RunningPenguin/ESP32_GRBL_SUBD/ESP32_GRBL_SUBD/ESP32_GRBL_SUBD.kicad_pcb

## KiCad design ESP32_GRBL_SUBD/ESP32_GRBL_SUBD.kicad_pcb (2022-12-30)

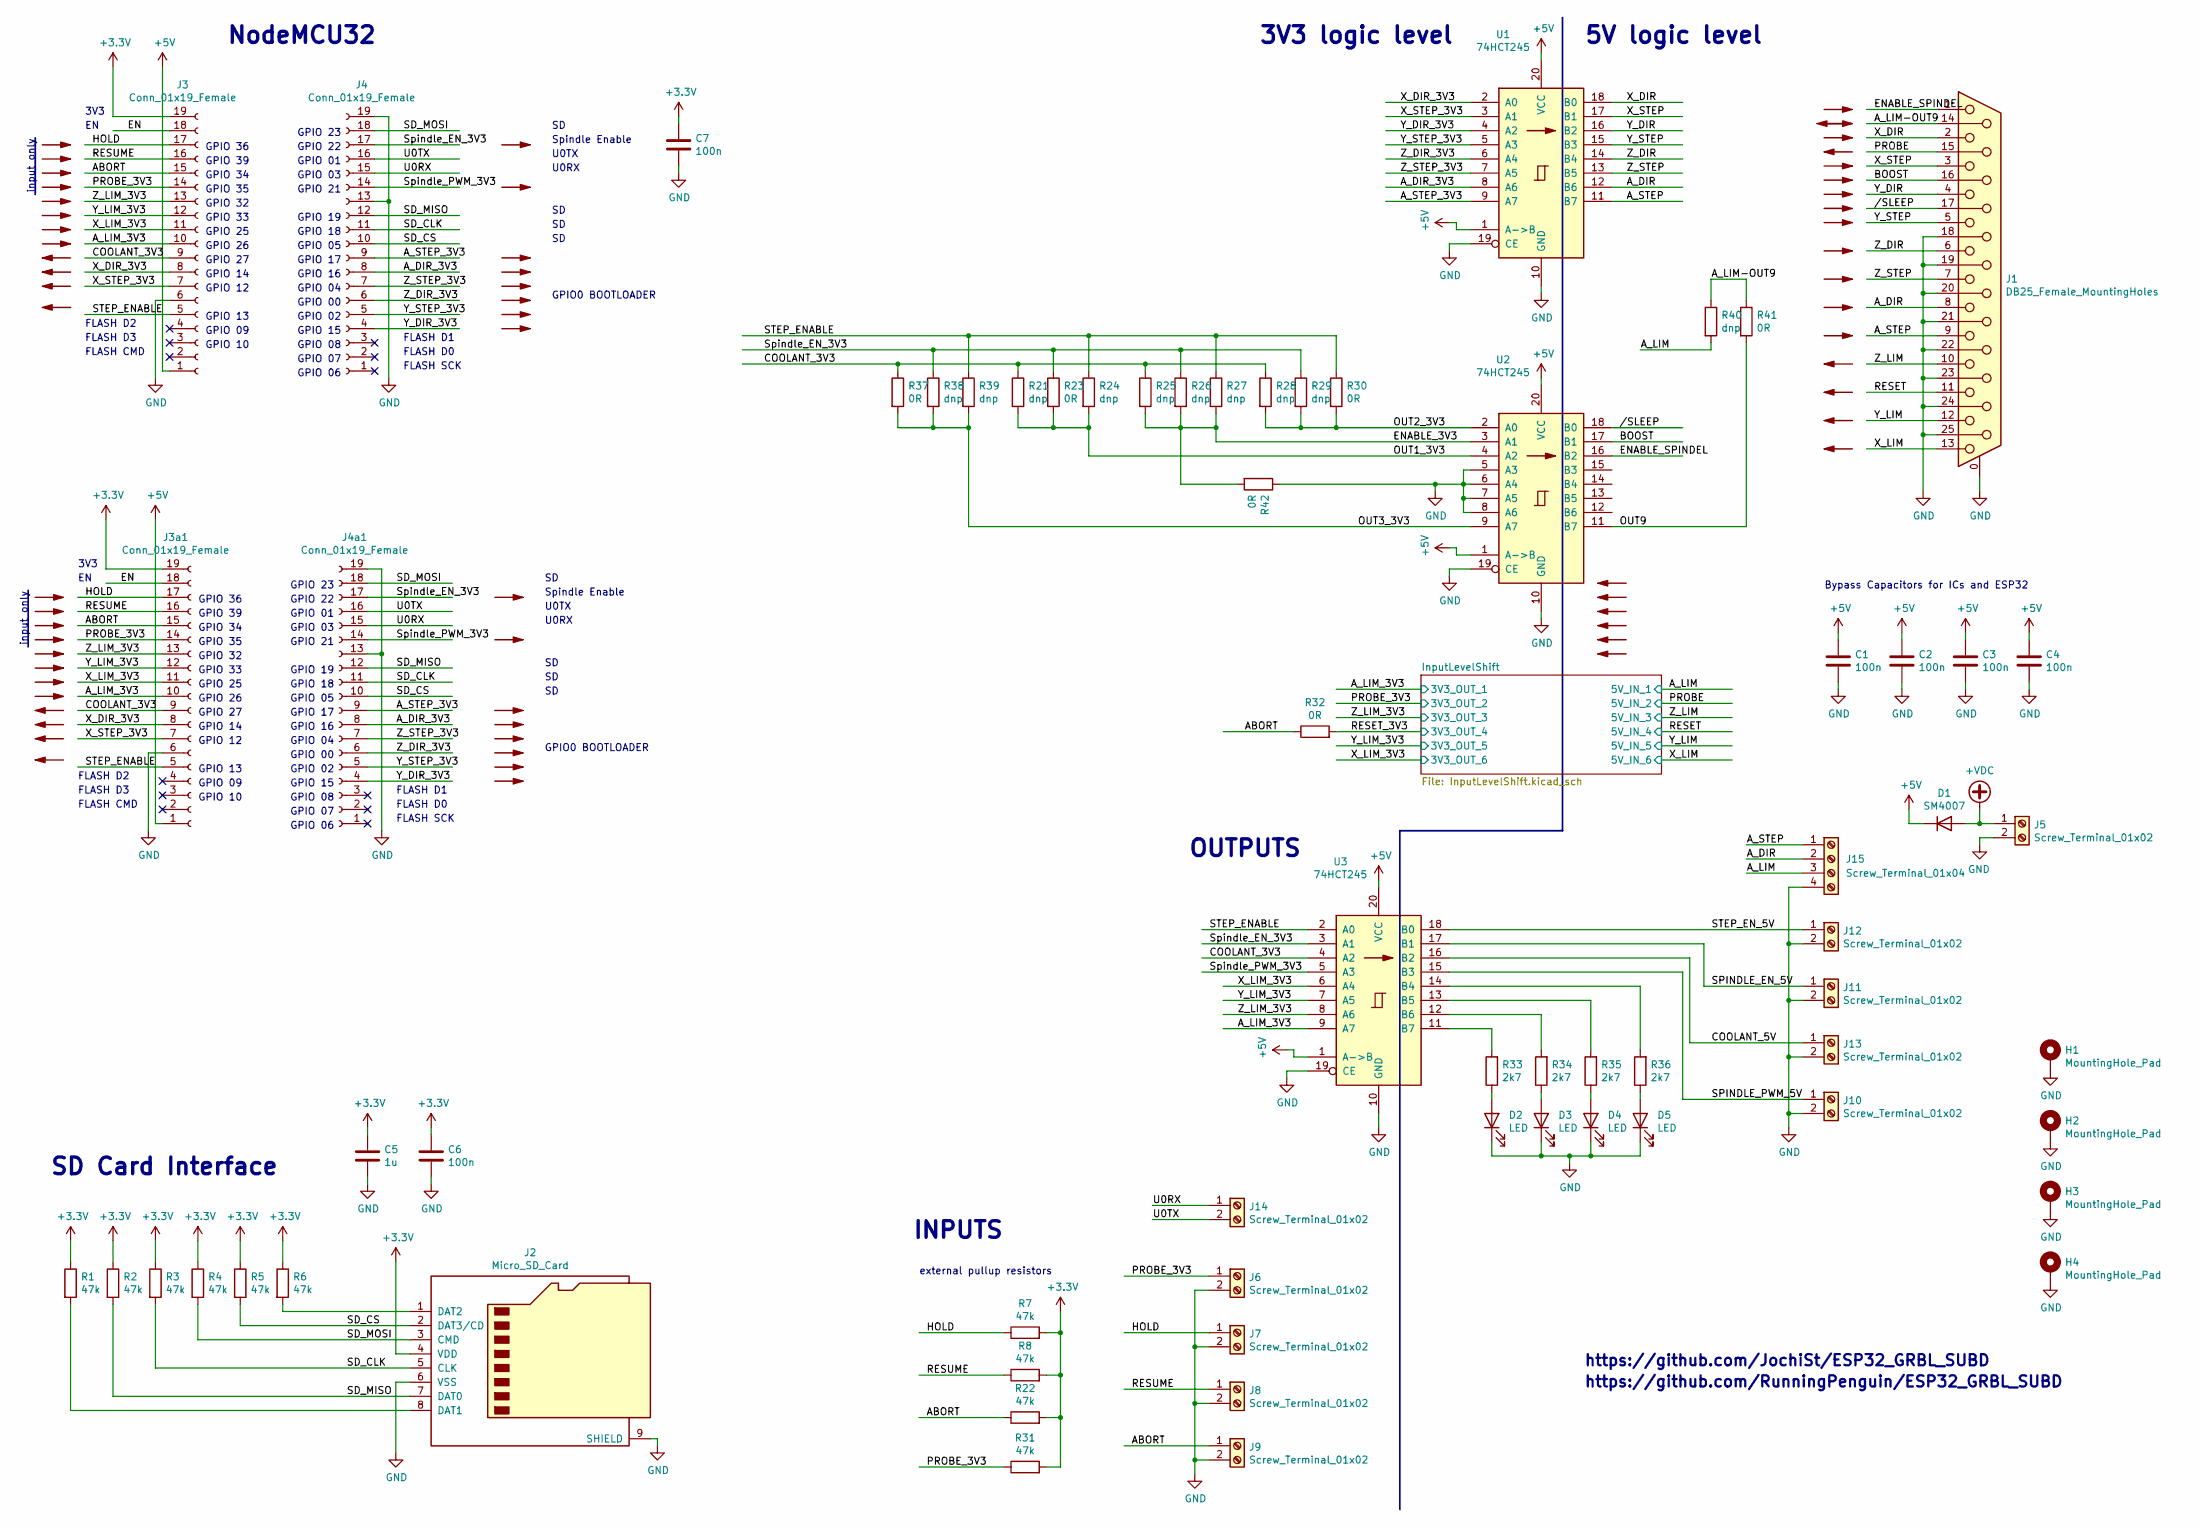
[picture p1: schematic ESP32_GRBL_SUBD.kicad_sch, ESP32 GRBL SUB-D25]

Parts:
C1, C2, C3, C4, C6, C7: 100n; C_0603_1608Metric
C5: 1u; C_0603_1608Metric
D1: SM4007; D_MELF
D2, D3, D4, D5: LED; LED_0603_1608Metric
H1, H2, H3, H4: MountingHole_Pad; MountingHole_3.2mm_M3_Pad_Via
J1: DB25_Female_MountingHoles; DSUB-25_Female_Horizontal_P2.77x2.84mm_EdgePinOffset7.70mm_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
J2: Micro_SD_Card; microSD_HC_Wuerth_693072010801
J3, J3a1, J4, J4a1: Conn_01x19_Female; PinSocket_1x19_P2.54mm_Vertical
J5, J6, J7, J8, J9, J10, J11, J12, J13, J14: Screw_Terminal_01x02; TerminalBlock_MetzConnect_Type055_RT01502HDWU_1x02_P5.00mm_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
J15: Screw_Terminal_01x04; TerminalBlock_MetzConnect_Type055_RT01504HDWU_1x04_P5.00mm_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
R1, R2, R3, R4, R5, R6, R7, R8, R22, R31: 47k; R_0603_1608Metric
R21, R24, R25, R26, R27, R28, R29, R38, R39, R40: dnp; R_0603_1608Metric
R23, R30, R32, R37, R41, R42: 0R; R_0603_1608Metric
R33, R34, R35, R36: 2k7; R_0603_1608Metric
U1, U2, U3: 74HCT245; SO-20_12.8x7.5mm_P1.27mm

Connections:
+3V3: C5.1, C6.1, C7.1, J2.4 (VDD), J3.19, J3a1.19, R1.1, R2.1, R3.1, R4.1, R5.1, R6.1, R7.2, R8.2, R22.2, R31.2; also elsewhere on the board
+5V: C1.1, C2.1, C3.1, C4.1, D1.1 (K), J3.1, J3a1.1, U1.1 (A->B), U1.20 (VCC), U2.1 (A->B), U2.20 (VCC), U3.1 (A->B), U3.20 (VCC); also elsewhere on the board
+VDC: D1.2 (A), J5.1
/ABORT: J3.15, J3a1.15, J9.1, R22.1, R32.1
/A_DIR: J1.8, J15.2, U1.12 (B6)
/A_DIR_3V3: J4.8, J4a1.8, U1.8 (A6)
/A_LIM: J15.3, R40.2; also elsewhere on the board
/A_LIM-OUT9: J1.14, R40.1, R41.1
/A_LIM_3V3: J3.10, J3a1.10, U3.9 (A7); also elsewhere on the board
/A_STEP: J1.9, J15.1, U1.11 (B7)
/A_STEP_3V3: J4.9, J4a1.9, U1.9 (A7)
/BOOST: J1.16, U2.17 (B1)
/COOLANT_3V3: J3.9, J3a1.9, R21.1, R25.1, R28.1, R37.1, U3.4 (A2)
/COOLANT_5V: J13.1, U3.16 (B2)
/EN: J3.18, J3a1.18
/ENABLE_3V3: R25.2, R26.2, R27.2, R42.2, U2.3 (A1)
/ENABLE_SPINDEL: J1.1, U2.16 (B2)
/HOLD: J3.17, J3a1.17, J7.1, R7.1
/OUT1_3V3: R21.2, R23.2, R24.2, U2.4 (A2)
/OUT2_3V3: R28.2, R29.2, R30.2, U2.2 (A0)
/OUT3_3V3: R37.2, R38.2, R39.2, U2.9 (A7)
/OUT9: R41.2, U2.11 (B7)
/PROBE: J1.15; also elsewhere on the board
/PROBE_3V3: J3.14, J3a1.14, J6.1, R31.1; also elsewhere on the board
/RESET: J1.11; also elsewhere on the board
/RESET_3V3: R32.2; also elsewhere on the board
/RESUME: J3.16, J3a1.16, J8.1, R8.1
/SD_CLK: J2.5 (CLK), J4.11, J4a1.11, R3.2
/SD_CS: J2.2 (DAT3/CD), J4.10, J4a1.10, R5.2
/SD_MISO: J2.7 (DAT0), J4.12, J4a1.12, R2.2
/SD_MOSI: J2.3 (CMD), J4.18, J4a1.18, R4.2
/SPINDLE_EN_5V: J11.1, U3.17 (B1)
/SPINDLE_PWM_5V: J10.1, U3.15 (B3)
/STEP_ENABLE: J3.5, J3a1.5, R24.1, R27.1, R30.1, R39.1, U3.2 (A0)
/STEP_EN_5V: J12.1, U3.18 (B0)
/Spindle_EN_3V3: J4.17, J4a1.17, R23.1, R26.1, R29.1, R38.1, U3.3 (A1)
/Spindle_PWM_3V3: J4.14, J4a1.14, U3.5 (A3)
/U0RX: J4.15, J4a1.15, J14.1
/U0TX: J4.16, J4a1.16, J14.2
/X_DIR: J1.2, U1.18 (B0)
/X_DIR_3V3: J3.8, J3a1.8, U1.2 (A0)
/X_LIM: J1.13; also elsewhere on the board
/X_LIM_3V3: J3.11, J3a1.11, U3.6 (A4); also elsewhere on the board
/X_STEP: J1.3, U1.17 (B1)
/X_STEP_3V3: J3.7, J3a1.7, U1.3 (A1)
/Y_DIR: J1.4, U1.16 (B2)
/Y_DIR_3V3: J4.4, J4a1.4, U1.4 (A2)
/Y_LIM: J1.12; also elsewhere on the board
/Y_LIM_3V3: J3.12, J3a1.12, U3.7 (A5); also elsewhere on the board
/Y_STEP: J1.5, U1.15 (B3)
/Y_STEP_3V3: J4.5, J4a1.5, U1.5 (A3)
/Z_DIR: J1.6, U1.14 (B4)
/Z_DIR_3V3: J4.6, J4a1.6, U1.6 (A4)
/Z_LIM: J1.10; also elsewhere on the board
/Z_LIM_3V3: J3.13, J3a1.13, U3.8 (A6); also elsewhere on the board
/Z_STEP: J1.7, U1.13 (B5)
/Z_STEP_3V3: J4.7, J4a1.7, U1.7 (A5)
//SLEEP: J1.17, U2.18 (B0)
GND: C1.2, C2.2, C3.2, C4.2, C5.2, C6.2, C7.2, D2.1 (K), D3.1 (K), D4.1 (K), D5.1 (K), H1.1, H2.1, H3.1, H4.1, J1.0 (PAD), J1.18, J1.19, J1.20, J1.21, J1.22, J1.23, J1.24, J1.25, J2.6 (VSS), J2.9 (SHIELD), J3.6, J3a1.6, J4.13, J4.19, J4a1.13, J4a1.19, J5.2, J6.2, J7.2, J8.2, J9.2, J10.2, J11.2, J12.2, J13.2, J15.4, R42.1, U1.10 (GND), U1.19 (CE), U2.5 (A3), U2.6 (A4), U2.7 (A5), U2.8 (A6), U2.10 (GND), U2.19 (CE), U3.10 (GND), U3.19 (CE)
unnamed: D2.2 (A), R33.1
unnamed: D3.2 (A), R34.1
unnamed: D4.2 (A), R35.1
unnamed: D5.2 (A), R36.1
unnamed: J2.1 (DAT2), R6.2
unnamed: J2.8 (DAT1), R1.2
unnamed: R33.2, U3.11 (B7)
unnamed: R34.2, U3.12 (B6)
unnamed: R35.2, U3.13 (B5)
unnamed: R36.2, U3.14 (B4)

Notes on the sheet:
GPIO 03
GPIO 19
GPIO 21
GPIO 01
GPIO 09
FLASH D0
GPIO 15
GPIO 27
GPIO 33
GPIO0 BOOTLOADER
GPIO 08
U0RX
FLASH CMD
GPIO 12
GPIO 32
GPIO 04
GPIO 02
3V3
GPIO 35
OUTPUTS
Spindle Enable
https://github.com/JochiSt/ESP32_GRBL_SUBD
GPIO 00
GPIO 23
GPIO 22
GPIO 25
Bypass Capacitors for ICs and ESP32
FLASH SCK
GPIO 34
GPIO 07
GPIO 10
5V logic level
input only
GPIO 36
FLASH D2
SD Card Interface
GPIO 26
GPIO 06
U0TX
GPIO 16
external pullup resistors
GPIO 05
GPIO 14
GPIO 17
FLASH D3
GPIO 18
NodeMCU32
GPIO 13
3V3 logic level
https://github.com/RunningPenguin/ESP32_GRBL_SUBD
FLASH D1
GPIO 39
INPUTS

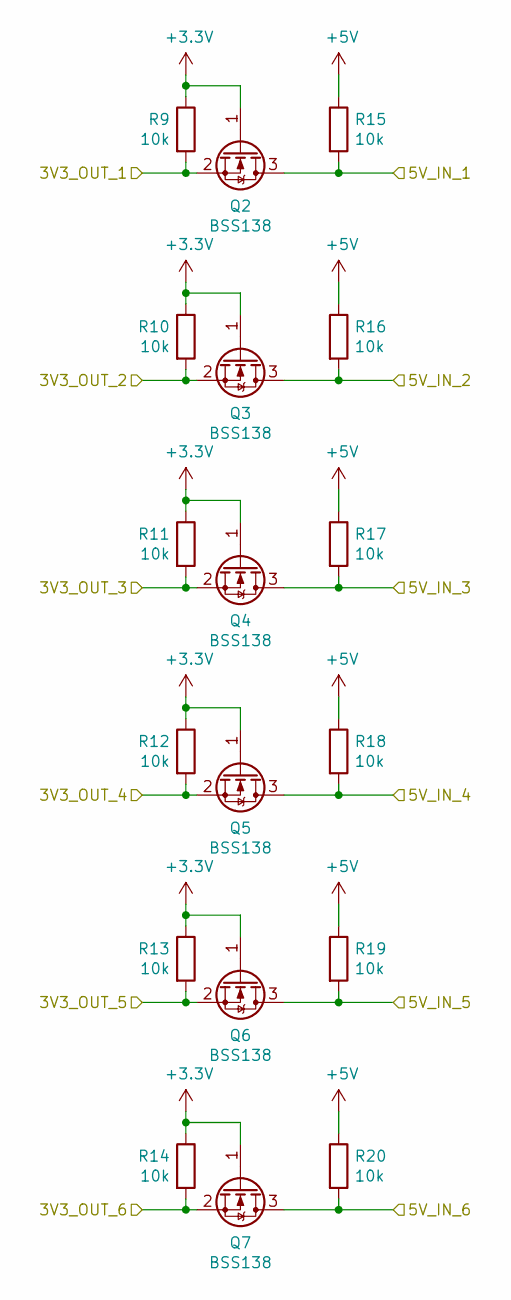
[picture p2: schematic InputLevelShift.kicad_sch, ESP32 GRBL SUB-D25]

Parts:
Q2, Q3, Q4, Q5, Q6, Q7: BSS138; SOT-23
R9, R10, R11, R12, R13, R14, R15, R16, R17, R18, R19, R20: 10k; R_0603_1608Metric

Connections:
+3V3: Q2.1 (G), Q3.1 (G), Q4.1 (G), Q5.1 (G), Q6.1 (G), Q7.1 (G), R9.1, R10.1, R11.1, R12.1, R13.1, R14.1; also elsewhere on the board
+5V: R15.1, R16.1, R17.1, R18.1, R19.1, R20.1; also elsewhere on the board
/A_LIM: Q2.3 (D), R15.2; also elsewhere on the board
/A_LIM_3V3: Q2.2 (S), R9.2; also elsewhere on the board
/PROBE: Q3.3 (D), R16.2; also elsewhere on the board
/PROBE_3V3: Q3.2 (S), R10.2; also elsewhere on the board
/RESET: Q5.3 (D), R18.2; also elsewhere on the board
/RESET_3V3: Q5.2 (S), R12.2; also elsewhere on the board
/X_LIM: Q7.3 (D), R20.2; also elsewhere on the board
/X_LIM_3V3: Q7.2 (S), R14.2; also elsewhere on the board
/Y_LIM: Q6.3 (D), R19.2; also elsewhere on the board
/Y_LIM_3V3: Q6.2 (S), R13.2; also elsewhere on the board
/Z_LIM: Q4.3 (D), R17.2; also elsewhere on the board
/Z_LIM_3V3: Q4.2 (S), R11.2; also elsewhere on the board

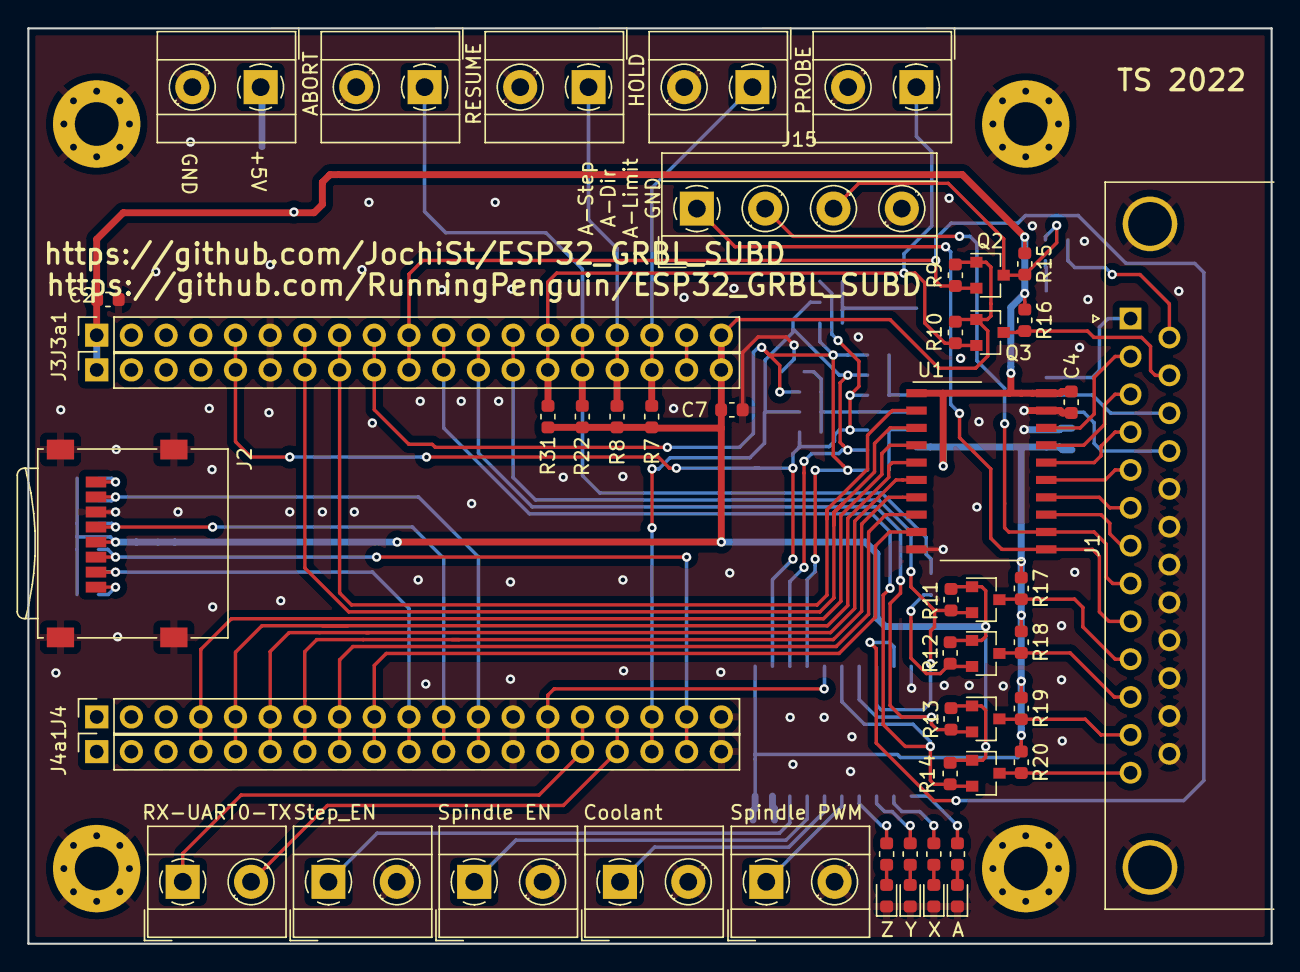
[picture p3: board ESP32_GRBL_SUBD.kicad_pcb from above]

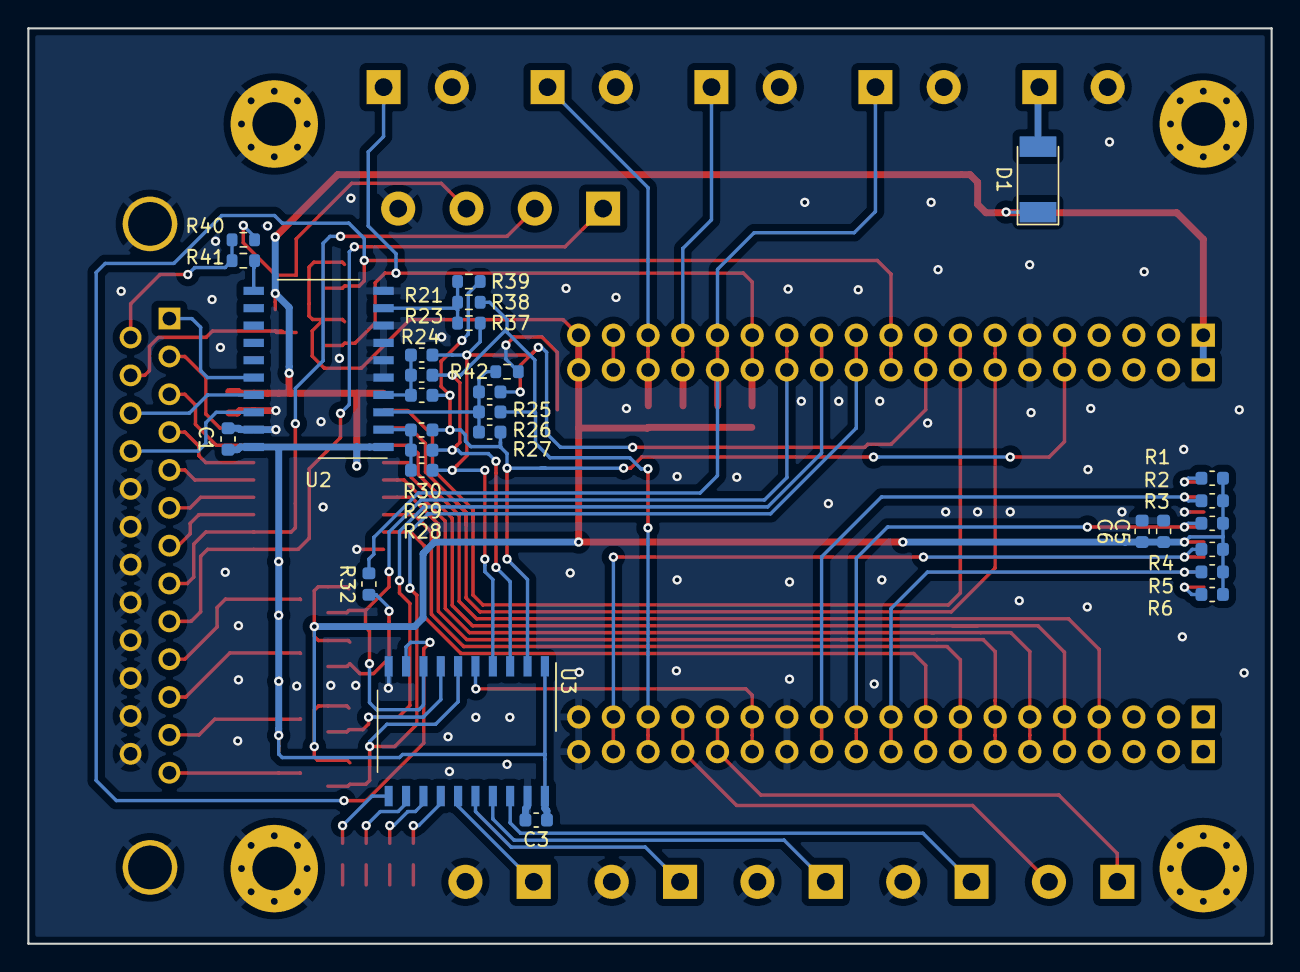
[picture p4: board ESP32_GRBL_SUBD.kicad_pcb from below]

Board: 2 copper layers, 91.0 x 67.0 mm, 84 parts (29 on the bottom side), 69 nets.
