RunningPenguin/ESP32_GRBL_SUBD/(commit log)

2022-12-18 D-Sub Pin 14 could be either a input or an output because my CNC milling machine uses this pin to switch on the coolant
    [ESP32_GRBL_SUBD.kicad_sch, ESP32_GRBL_SUBD.sch, InputLevelShift.kicad_sch, InputLevelShift.sch]
2022-12-18 D-Sub Pin 14 could be either a input or an output because my CNC milling machine uses this pin to switch on the coolant. Untested PCB added
    [ESP32_GRBL_SUBD.kicad_pcb]
2022-12-18 One unused output pin resistor to GND added. The logic level converter shouldnt be floating
    [ESP32_GRBL_SUBD.kicad_pcb, ESP32_GRBL_SUBD.kicad_sch, InputLevelShift.kicad_sch]
2022-12-19 mapped UART0 to screw header
    [ESP32_GRBL_SUBD.kicad_pcb, ESP32_GRBL_SUBD.kicad_sch]
2022-12-30 Configuration changed to L297/L298 Stepper driver from my CNC machine
    [myconfig.yaml]
2022-12-30 wired Axis a to screw terminals
    [ESP32_GRBL_SUBD.kicad_pcb, ESP32_GRBL_SUBD.kicad_sch]
